naisy/overdrive/README_teensy40_overdrive_beta2.md

最新動作確認

Arduino 2.3.6
https://www.arduino.cc/en/software/

Teensyduino, Version 1.59
https://www.pjrc.com/teensy/td_download.html
