naisy/overdrive/myconfig_overdrive4/config_dewarper_320x24_tt02.txt

[property]
output-width=320
output-height=24
num-batch-buffers=1

[surface0]
# 1=PushBroom, 2=VertRadCyl 3= Perspective_Perspective FISH_PERSPECTIVE=4, FISH_FISH=5, FISH_CYL=6, FISH_EQUIRECT=7,
# FISH_PANINI=8, PERSPECTIVE_EQUIRECT=9, PERSPECTIVE_PANINI=10, EQUIRECT_CYLINDER=11, EQUIRECT_EQUIRECT=12 EQUIRECT_FISHEYE=13,
# EQUIRECT_PANINI=14, EQUIRECT_PERSPECTIVE=15, EQUIRECT_PUSHBROOM=16, EQUIRECT_STEREOGRAPHIC=17, EQUIRECT_VERTCYLINDER=18
projection-type=2
surface-index=0
width=320
height=24
# ROI
top-angle=82
bottom-angle=89
pitch=88.5
yaw=-88
roll=90
focal-length=170
