naisy/overdrive/(commit log)

2020-03-01 add teensy40 overdrive beta1
2020-03-02 add camera.py
2020-03-02 fix led pin number
    [teensy40_overdrive_beta1.ino]
2020-03-04 update pwm neutral value
2020-03-05 update led
2020-03-06 update led after fire
2020-07-25 update default track to mountain
2020-07-26 add constant throttle adder
2021-02-22 add calibration file
2021-02-23 update calibration file
2021-12-17 fix led error
2021-12-20 skip unused led pin
    [teensy40_overdrive_beta1.ino]
2022-09-08 insert time to micros_last[RECV_CH1/CH2]
2022-09-25 fix after fire 2
    [teensy40_overdrive_beta1.ino]
2023-09-01 add nvdewarper
    [config_dewarper_tt02.txt]
2023-11-27 add GAIN
    [config_dewarper_tt02_12pix.txt]
